Gregox273/Nixie-Clock-legacy/Readme.txt

Arduino programs for Arduino based nixie clock project.

Custom PCB using IN-14 nixies, K155ID1 drivers and 74HC595 shift registers.
