Gregox273/Nixie-Clock-legacy/Schematic.png

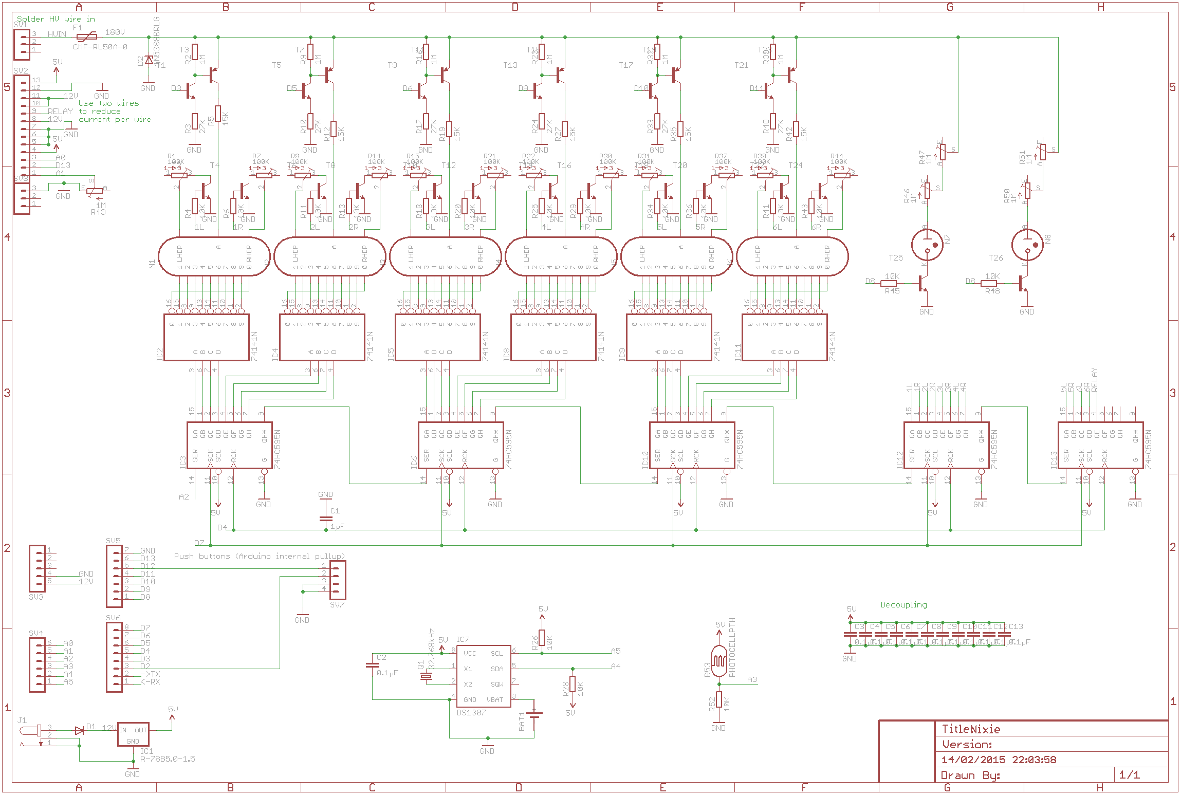
Schematic.png
