Gregox273/Nixie-Clock-legacy/Nixie.sch

## EAGLE design Nixie.sch (2015-02-16)

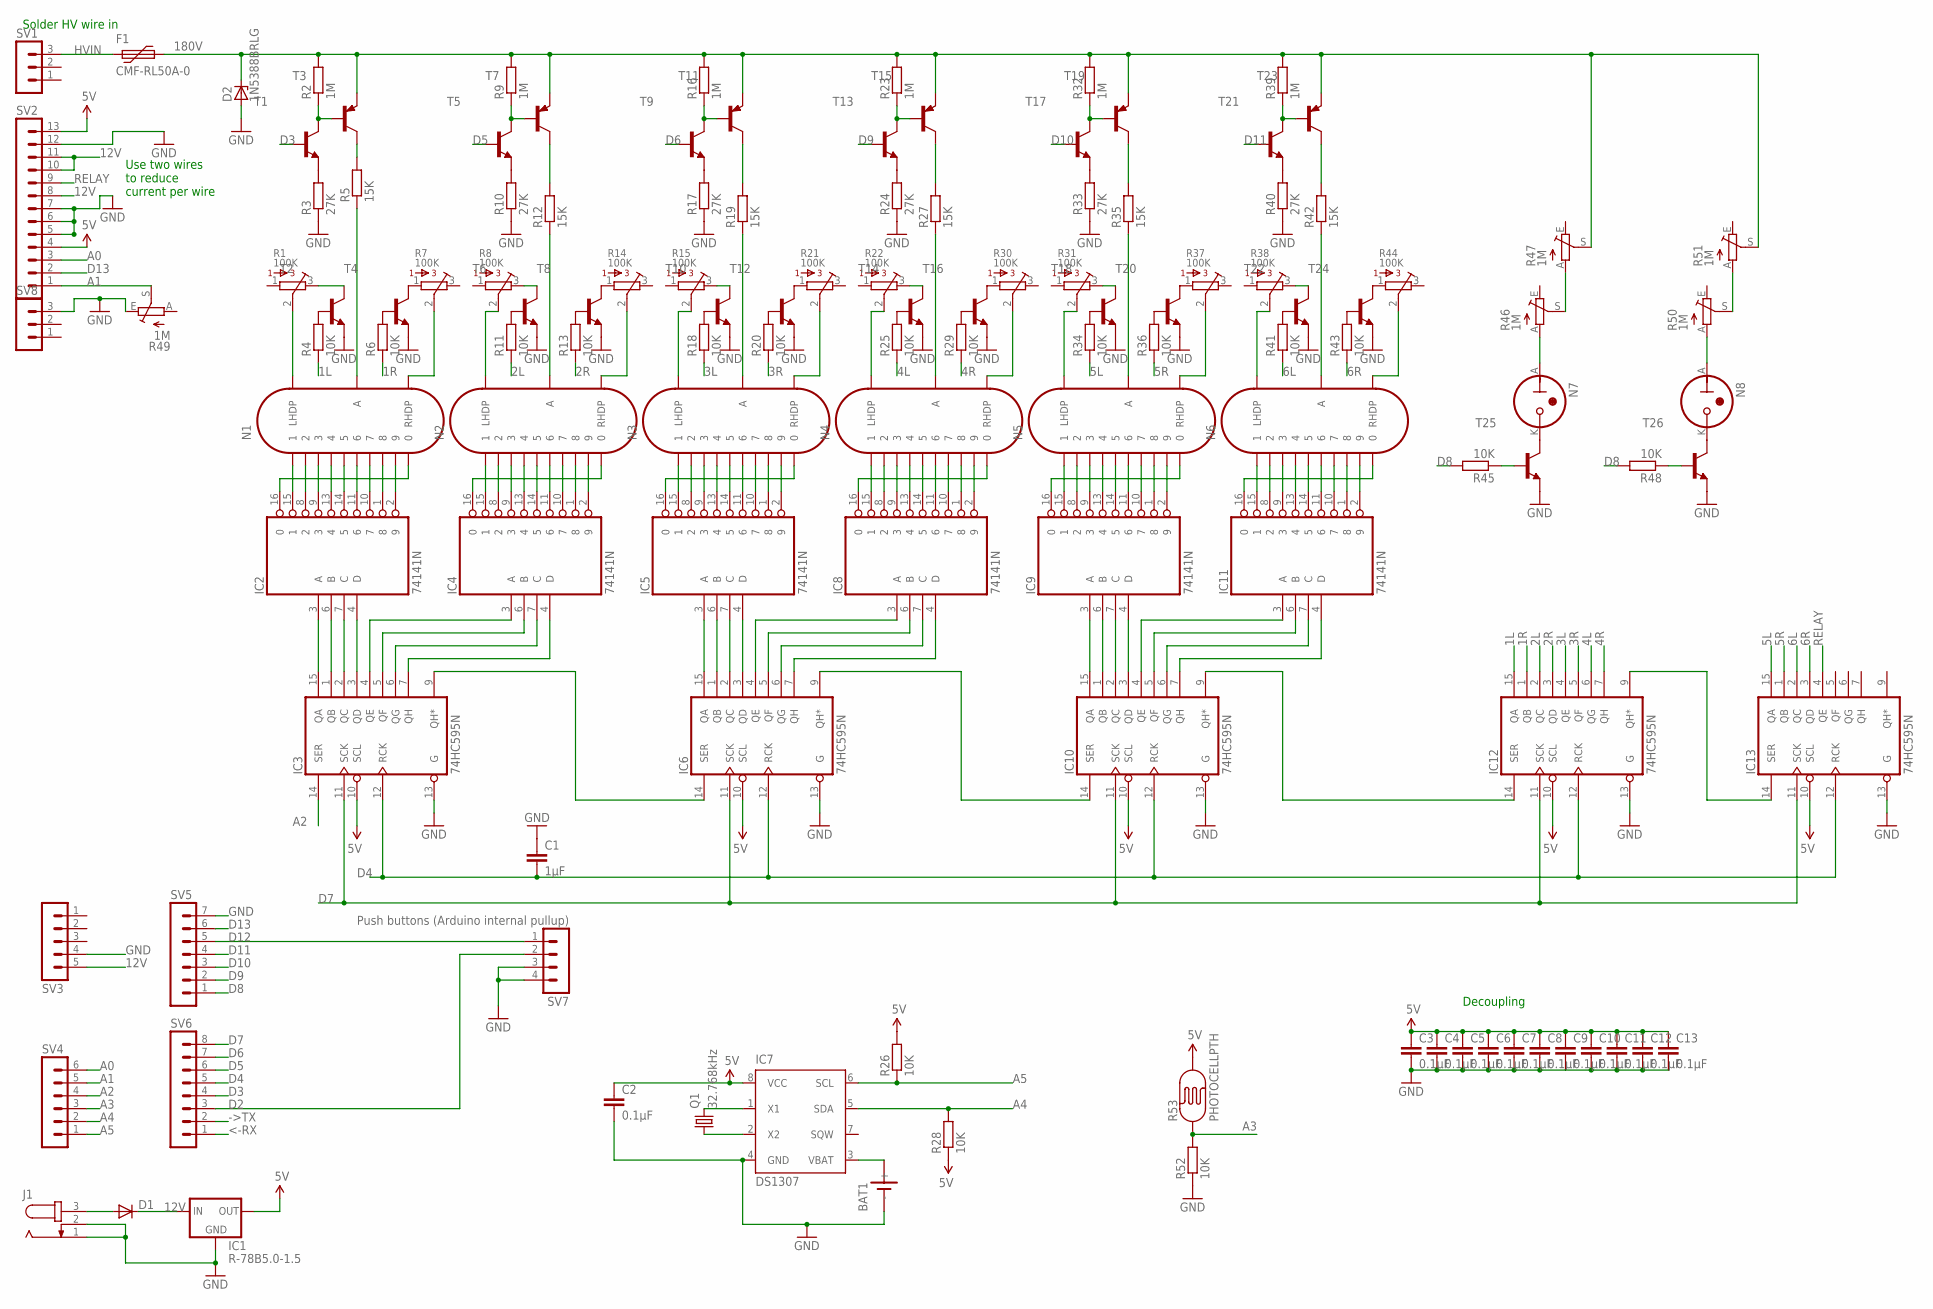
[picture p2: schematic Nixie.sch]

Parts:
BAT1: SN2032
C1: 1μF; C2.5-2
C2, C3, C4, C5, C6, C7, C8, C9, C10, C11, C12, C13: 0.1μF; C2.5-2
D1: 1N5400; DO201-15
D2: 1N5388BRLG; C1702-15
F1: CMF-RL50A-0; MF-5,1
IC1: R-78B5.0-1.5; SIP3V
IC2, IC4, IC5, IC8, IC9, IC11: 74141N; DIL16
IC3, IC6, IC10, IC12, IC13: 74HC595N; DIL16
IC7: DS1307; DIL08
J1: JACK-PLUG0; SPC4077
N1, N2, N3, N4, N5, N6: IN-14
N7, N8: IN-3
Q1: 32.768kHz; TC26V
R1, R7, R8, R14, R15, R21, R22, R30, R31, R37, R38, R44: 100K; 3362P
R2, R9, R16, R23, R32, R39: 1M; 0207/10
R3, R10, R17, R24, R33, R40: 27K; 0207/10
R4, R6, R11, R13, R18, R20, R25, R26, R28, R29, R34, R36, R41, R43, R45, R48, R52: 10K; 0207/10
R5, R12, R19, R27, R35, R42: 15K; 0207/10
R46, R47, R49, R50, R51: 1M; ECP10S
R53: PHOTOCELLPTH; PHOTOCELL
SV1, SV8: MA03-1
SV2: MA13-1
SV3: MA05-1
SV4: MA06-1
SV5: MA07-1
SV6: MA08-1
SV7: Push buttons (Arduino internal pullup); MA04-1
T1, T2, T4, T5, T6, T8, T9, T10, T12, T13, T14, T16, T17, T18, T20, T21, T22, T24, T25, T26: MPSA42-NPN-TO92-CBE; TO92-CBE
T3, T7, T11, T15, T19, T23: BC327-16-PNP-TO92-EBC; TO92-EBC

Connections:
1L: IC12.15 (QA), R4.1
1R: IC12.1 (QB), R6.1
2L: IC12.2 (QC), R11.1
2R: IC12.3 (QD), R13.1
3L: IC12.4 (QE), R18.1
3R: IC12.5 (QF), R20.1
4L: IC12.6 (QG), R25.1
4R: IC12.7 (QH), R29.1
5L: IC13.15 (QA), R34.1
5R: IC13.1 (QB), R36.1
6L: IC13.2 (QC), R41.1
6R: IC13.3 (QD), R43.1
12V: D1.C, IC1.1 (IN), SV2.8, SV2.10, SV2.11, SV3.5
180V: D2.C, F1.2, R2.2, R9.2, R16.2, R23.2, R32.2, R39.2, R47.S, R51.S, T3.E, T7.E, T11.E, T15.E, T19.E, T23.E
->TX: SV6.2
<-RX: SV6.1
A0: SV2.3, SV4.6
A1: R49.S, SV2.1, SV4.5
A2: IC3.14 (SER), SV4.4
A3: R52.2, R53.1, SV4.3
A4: IC7.5 (SDA), R28.2, SV4.2
A5: IC7.6 (SCL), R26.1, SV4.1
D2: SV6.3, SV7.2
D3: SV6.4, T1.B
D4: C1.2, IC3.12 (RCK), IC6.12 (RCK), IC10.12 (RCK), IC12.12 (RCK), IC13.12 (RCK), SV6.5
D5: SV6.6, T5.B
D6: SV6.7, T9.B
D7: IC3.11 (SCK), IC6.11 (SCK), IC10.11 (SCK), IC12.11 (SCK), IC13.11 (SCK), SV6.8
D8: R45.2, R48.2, SV5.1
D9: SV5.2, T13.B
D10: SV5.3, T17.B
D11: SV5.4, T21.B
D12: SV5.5, SV7.1
D13: SV2.2, SV5.6
GND: BAT1.-, C1.1, C2.2, C3.2, C4.2, C5.2, C6.2, C7.2, C8.2, C9.2, C10.2, C11.2, C12.2, C13.2, D2.A, IC1.2 (GND), IC3.13 (G), IC6.13 (G), IC7.4 (GND), IC10.13 (G), IC12.13 (G), IC13.13 (G), J1.1, J1.2, R3.1, R10.1, R17.1, R24.1, R33.1, R40.1, R49.E, R52.1, SV2.5, SV2.6, SV2.7, SV2.12, SV3.4, SV5.7, SV7.3, SV7.4, SV8.3, T2.E, T4.E, T6.E, T8.E, T10.E, T12.E, T14.E, T16.E, T18.E, T20.E, T22.E, T24.E, T25.E, T26.E
HVIN: F1.1, SV1.3
unnamed: N1.RHDP, R7.2
unnamed: IC3.9 (QH*), IC6.14 (SER)
unnamed: IC6.9 (QH*), IC10.14 (SER)
unnamed: IC10.9 (QH*), IC12.14 (SER)
unnamed: IC12.9 (QH*), IC13.14 (SER)
unnamed: IC2.3 (A), IC3.15 (QA)
unnamed: IC2.6 (B), IC3.1 (QB)
unnamed: IC2.7 (C), IC3.2 (QC)
unnamed: IC2.4 (D), IC3.3 (QD)
unnamed: IC3.4 (QE), IC4.3 (A)
unnamed: IC3.5 (QF), IC4.6 (B)
unnamed: IC3.6 (QG), IC4.7 (C)
unnamed: IC3.7 (QH), IC4.4 (D)
unnamed: IC5.3 (A), IC6.15 (QA)
unnamed: IC5.6 (B), IC6.1 (QB)
unnamed: IC5.7 (C), IC6.2 (QC)
unnamed: IC5.4 (D), IC6.3 (QD)
unnamed: IC6.4 (QE), IC8.3 (A)
unnamed: IC6.5 (QF), IC8.6 (B)
unnamed: IC6.6 (QG), IC8.7 (C)
unnamed: IC6.7 (QH), IC8.4 (D)
unnamed: IC9.3 (A), IC10.15 (QA)
unnamed: IC9.6 (B), IC10.1 (QB)
unnamed: IC9.7 (C), IC10.2 (QC)
unnamed: IC9.4 (D), IC10.3 (QD)
unnamed: IC10.4 (QE), IC11.3 (A)
unnamed: IC10.5 (QF), IC11.6 (B)
unnamed: IC10.6 (QG), IC11.7 (C)
unnamed: IC10.7 (QH), IC11.4 (D)
unnamed: IC2.15 (1), N1.1
unnamed: IC2.8 (2), N1.2
unnamed: IC2.9 (3), N1.3
unnamed: IC2.13 (4), N1.4
unnamed: IC2.14 (5), N1.5
unnamed: IC2.11 (6), N1.6
unnamed: IC2.10 (7), N1.7
unnamed: IC2.1 (8), N1.8
unnamed: IC2.2 (9), N1.9
unnamed: IC2.16 (0), N1.0
unnamed: IC4.15 (1), N2.1
unnamed: IC4.8 (2), N2.2
unnamed: IC4.9 (3), N2.3
unnamed: IC4.13 (4), N2.4
unnamed: IC4.14 (5), N2.5
unnamed: IC4.11 (6), N2.6
unnamed: IC4.10 (7), N2.7
unnamed: IC4.1 (8), N2.8
unnamed: IC4.2 (9), N2.9
unnamed: IC4.16 (0), N2.0
unnamed: IC5.15 (1), N3.1
unnamed: IC5.8 (2), N3.2
unnamed: IC5.9 (3), N3.3
unnamed: IC5.13 (4), N3.4
unnamed: IC5.14 (5), N3.5
unnamed: IC5.11 (6), N3.6
unnamed: IC5.10 (7), N3.7
unnamed: IC5.1 (8), N3.8
unnamed: IC5.2 (9), N3.9
unnamed: IC5.16 (0), N3.0
unnamed: IC8.15 (1), N4.1
unnamed: IC8.8 (2), N4.2
unnamed: IC8.9 (3), N4.3
unnamed: IC8.13 (4), N4.4
unnamed: IC8.14 (5), N4.5
unnamed: IC8.11 (6), N4.6
unnamed: IC8.10 (7), N4.7
unnamed: IC8.1 (8), N4.8
unnamed: IC8.2 (9), N4.9
unnamed: IC8.16 (0), N4.0
unnamed: IC9.15 (1), N5.1
unnamed: IC9.8 (2), N5.2
unnamed: IC9.9 (3), N5.3
unnamed: IC9.13 (4), N5.4
unnamed: IC9.14 (5), N5.5
unnamed: IC9.11 (6), N5.6
unnamed: IC9.10 (7), N5.7
unnamed: IC9.1 (8), N5.8
unnamed: IC9.2 (9), N5.9
unnamed: IC9.16 (0), N5.0
unnamed: IC11.15 (1), N6.1
unnamed: IC11.8 (2), N6.2
unnamed: IC11.9 (3), N6.3
unnamed: IC11.13 (4), N6.4
unnamed: IC11.14 (5), N6.5
unnamed: IC11.11 (6), N6.6
unnamed: IC11.10 (7), N6.7
unnamed: IC11.1 (8), N6.8
unnamed: IC11.2 (9), N6.9
unnamed: IC11.16 (0), N6.0
unnamed: N1.A, R5.1
unnamed: N2.A, R12.1
unnamed: N3.A, R19.1
unnamed: N4.A, R27.1
unnamed: N5.A, R35.1
unnamed: N6.A, R42.1
unnamed: R2.1, T1.C, T3.B
unnamed: R5.2, T3.C
unnamed: R3.2, T1.E
unnamed: R9.1, T5.C, T7.B
unnamed: R12.2, T7.C
unnamed: R10.2, T5.E
unnamed: R16.1, T9.C, T11.B
unnamed: R19.2, T11.C
unnamed: R17.2, T9.E
unnamed: R23.1, T13.C, T15.B
unnamed: R27.2, T15.C
unnamed: R24.2, T13.E
unnamed: R32.1, T17.C, T19.B
unnamed: R35.2, T19.C
unnamed: R33.2, T17.E
unnamed: R39.1, T21.C, T23.B
unnamed: R42.2, T23.C
unnamed: R40.2, T21.E
unnamed: R6.2, T4.B
unnamed: R4.2, T2.B
unnamed: R11.2, T6.B
unnamed: R13.2, T8.B
unnamed: R18.2, T10.B
unnamed: R20.2, T12.B
unnamed: R25.2, T14.B
unnamed: R29.2, T16.B
unnamed: R34.2, T18.B
unnamed: R36.2, T20.B
unnamed: R41.2, T22.B
unnamed: R43.2, T24.B
unnamed: R1.3, T2.C
unnamed: R7.1, T4.C
unnamed: R8.3, T6.C
unnamed: R14.1, T8.C
unnamed: R21.1, T12.C
unnamed: R30.1, T16.C
unnamed: R37.1, T20.C
unnamed: R44.1, T24.C
unnamed: R15.3, T10.C
unnamed: N3.LHDP, R15.2
unnamed: R22.3, T14.C
unnamed: N4.LHDP, R22.2
unnamed: D1.A, J1.3
unnamed: IC7.1 (X1), Q1.2
unnamed: IC7.2 (X2), Q1.1
unnamed: BAT1.+, IC7.3 (VBAT)
unnamed: N1.LHDP, R1.2
unnamed: N2.RHDP, R14.2
unnamed: N3.RHDP, R21.2
unnamed: N4.RHDP, R30.2
unnamed: N5.RHDP, R37.2
unnamed: N6.RHDP, R44.2
unnamed: N2.LHDP, R8.2
unnamed: R31.3, T18.C
unnamed: N5.LHDP, R31.2
unnamed: N6.LHDP, R38.2
unnamed: R38.3, T22.C
unnamed: N7.A, R46.A
unnamed: N8.A, R50.A
unnamed: R46.S, R47.A
unnamed: R50.S, R51.A
unnamed: N7.K, T25.C
unnamed: N8.K, T26.C
unnamed: R45.1, T25.B
unnamed: R48.1, T26.B
RELAY: IC13.4 (QE), SV2.9
VCC: C2.1, C3.1, C4.1, C5.1, C6.1, C7.1, C8.1, C9.1, C10.1, C11.1, C12.1, C13.1, IC1.3 (OUT), IC3.10 (SCL), IC6.10 (SCL), IC7.8 (VCC), IC10.10 (SCL), IC12.10 (SCL), IC13.10 (SCL), R26.2, R28.1, R53.2, SV2.4, SV2.13

Notes on the sheet:
Use two wires to reduce current per wire
Solder HV wire in
Decoupling
