Gregox273/Nixie-Clock-legacy/(commit log)

2015-02-18 Fixed digit pair position error
    [Display_test.ino, Nixie_Clock.ino]
2015-02-18 Add digital pin functions
2015-02-19 Add multi coloured LED support
2015-12-15 Add cathode poisoning prevention and schedule it at 16:xx with gps time sync
    [Nixie_Clock.ino]
2015-12-23 Fix bug with fade effect when syncing with GPS time
    [GPS.cpp, Nixie_Clock.ino]
2016-04-02 Add temporary BST correction
    [GPS.cpp, Nixie_Clock.ino]
