Gregox273/Nixie-Clock-legacy/(notices)

Notices in the files:
parts and their libraries:
SparkFun-Aesthetics: Licensing: CC v3.0 Share-Alike You are welcome to use this library for commercial purposes.
r-78xx_10: (c) 2015 Samuel Lourenço
